ptmotorsport/PT-IMU2CAN/hardware/Altimeter.kicad_sch

## KiCad design hardware/Altimeter.kicad_sch (2026-09-11, an earlier design)

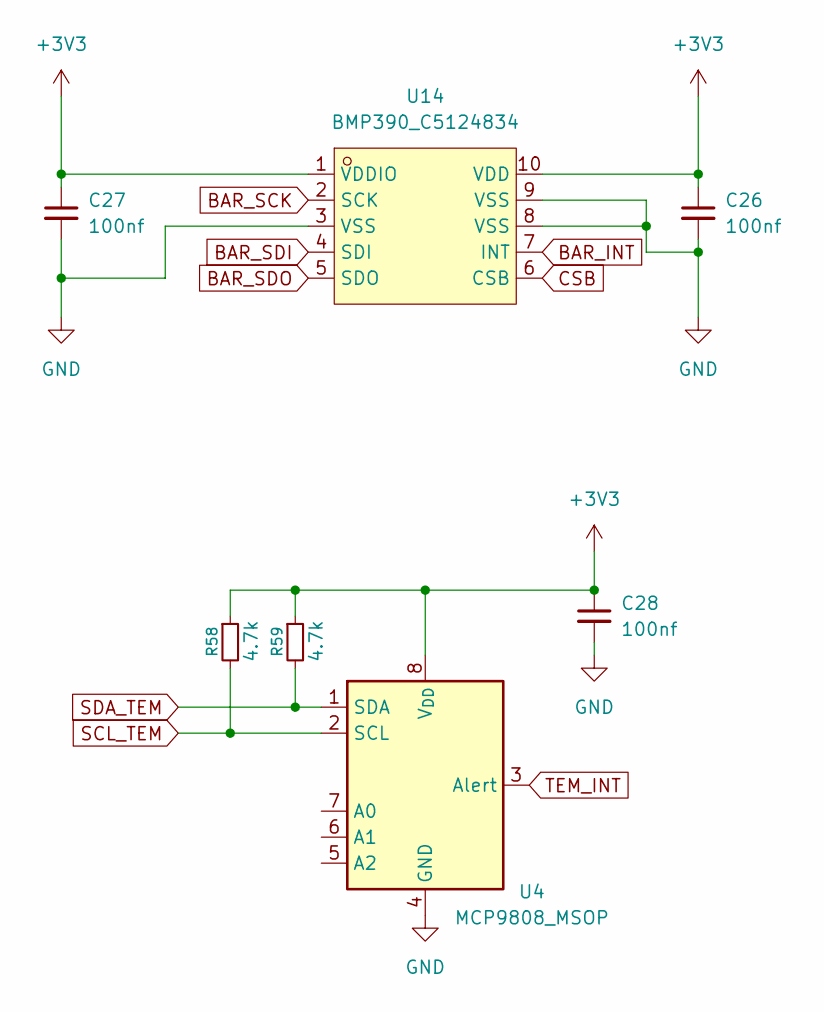
[picture p1: schematic Altimeter.kicad_sch]

Parts:
C26, C27, C28: 100nf
R58, R59: 4.7k
U4: MCP9808_MSOP; MSOP-8_3x3mm_P0.65mm
U14: BMP390_C5124834; LGA-10_L2.0-W2.0-P0.50-BL; MPN BMP390; LCSC Part C5124834

Connections:
+3V3: C26.1, C27.1, C28.1, R58.1, R59.1, U4.8 (V_{DD}), U14.1 (VDDIO), U14.10 (VDD)
BAR_INT: U14.7 (INT)
BAR_SCK: U14.2 (SCK)
BAR_SDI: U14.4 (SDI)
BAR_SDO: U14.5 (SDO)
CSB: U14.6 (CSB)
GND: C26.2, C27.2, C28.2, U4.4 (GND), U14.3 (VSS), U14.8 (VSS), U14.9 (VSS)
SCL_TEM: R58.2, U4.2 (SCL)
SDA_TEM: R59.2, U4.1 (SDA)
TEM_INT: U4.3 (Alert)
