ptmotorsport/PT-IMU2CAN/hardware/CAN.kicad_sch

## KiCad design hardware/CAN.kicad_sch (2026-07-16)

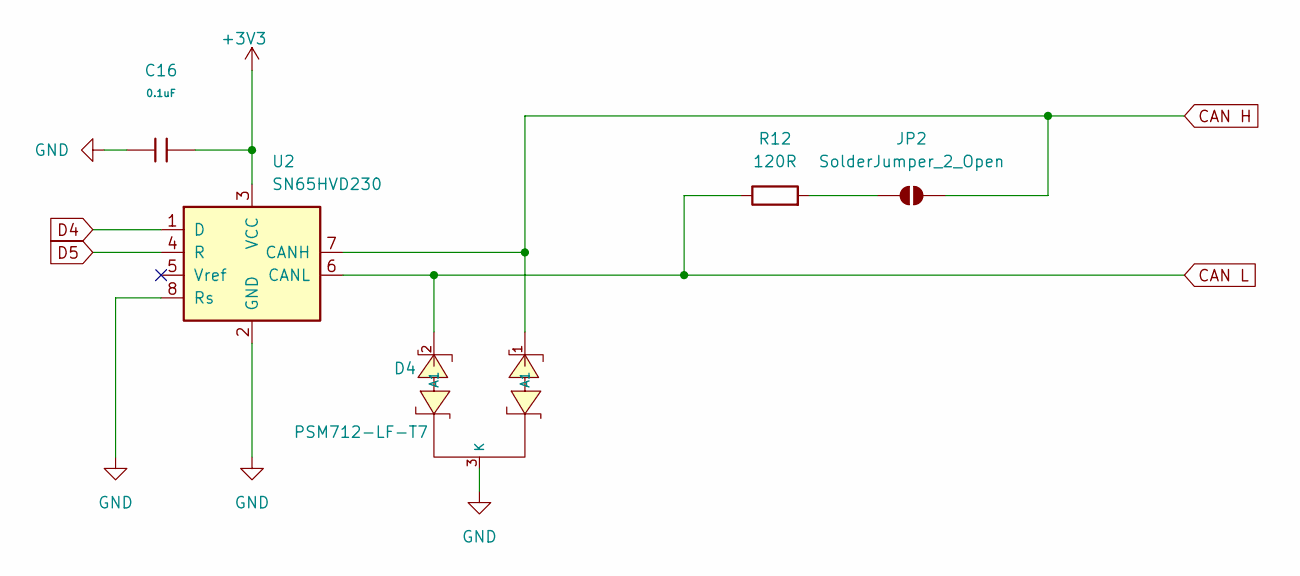
[picture p2: schematic CAN.kicad_sch]

Parts:
C16: 0.1uF; C_0402_1005Metric
D4: PSM712-LF-T7; SOT-23-3; Breakdown Voltage 13.3V; Part PSM712-LF-T7; LCSC C32677
JP2: SolderJumper_2_Open; SolderJumper-2_P1.3mm_Open_RoundedPad1.0x1.5mm
R12: 120R; R_0603_1608Metric
U2: SN65HVD230; SOIC-8_3.9x4.9mm_P1.27mm

Connections:
+3V3: C16.2, U2.3 (VCC)
CAN H: D4.1 (A1), JP2.2 (B), U2.7 (CANH)
CAN L: D4.2 (A1), R12.1, U2.6 (CANL)
D4: U2.1 (D)
D5: U2.4 (R)
GND: C16.1, D4.3 (K), U2.2 (GND), U2.8 (Rs)
unnamed: JP2.1 (A), R12.2
