ptmotorsport/PT-IMU2CAN/hardware/Connectors.kicad_sch

## KiCad design hardware/Connectors.kicad_sch (2026-07-16)

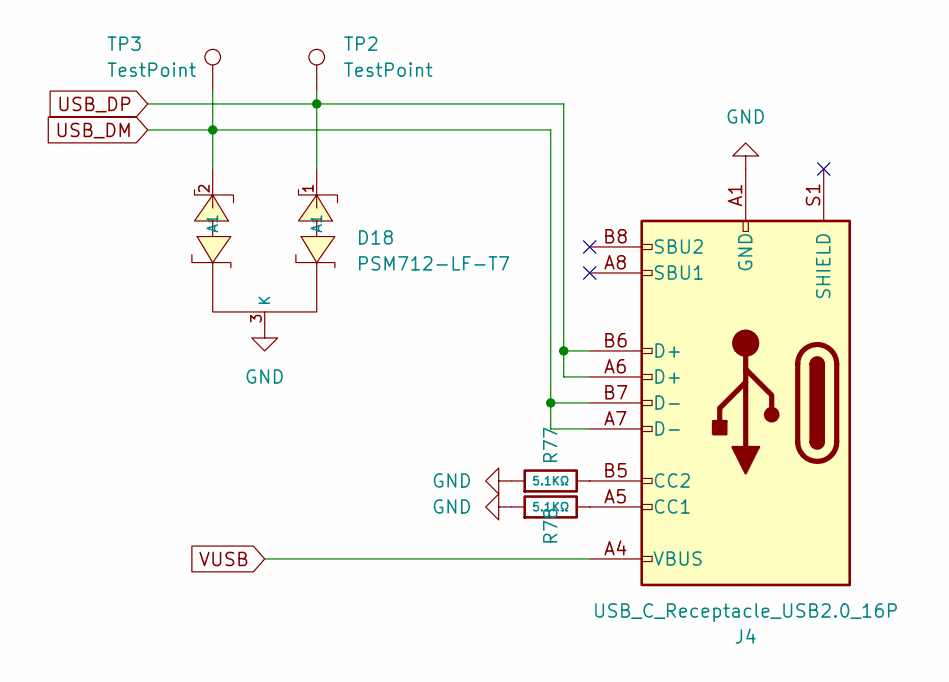
[picture p3: schematic Connectors.kicad_sch]

Parts:
D18: PSM712-LF-T7; SOT-23-3; Breakdown Voltage 13.3V; Part PSM712-LF-T7; LCSC C32677
J4: USB_C_Receptacle_USB2.0_16P; USB_C_Receptacle_GCT_USB4105-xx-A_16P_TopMnt_Horizontal; LCSC C393939
R77, R78: 5.1KΩ; R_0402_1005Metric; Overload Voltage (Max) 50V; Tolerance ±1%; Part 0402WGF1501TCE; LCSC C25867
TP2, TP3: TestPoint; TestPoint_Pad_D1.5mm

Connections:
GND: D18.3 (K), J4.A1 (GND), J4.A12 (GND), J4.B1 (GND), J4.B12 (GND), R77.1, R78.1
unnamed: J4.A5 (CC1), R78.2
unnamed: J4.B5 (CC2), R77.2
USB_DM: D18.2 (A1), J4.A7 (D-), J4.B7 (D-), TP3.1
USB_DP: D18.1 (A1), J4.A6 (D+), J4.B6 (D+), TP2.1
VUSB: J4.A4 (VBUS), J4.A9 (VBUS), J4.B4 (VBUS), J4.B9 (VBUS)
