ptmotorsport/PT-IMU2CAN/hardware/GPS.kicad_sch

## KiCad design hardware/GPS.kicad_sch (2026-09-11, an earlier design)

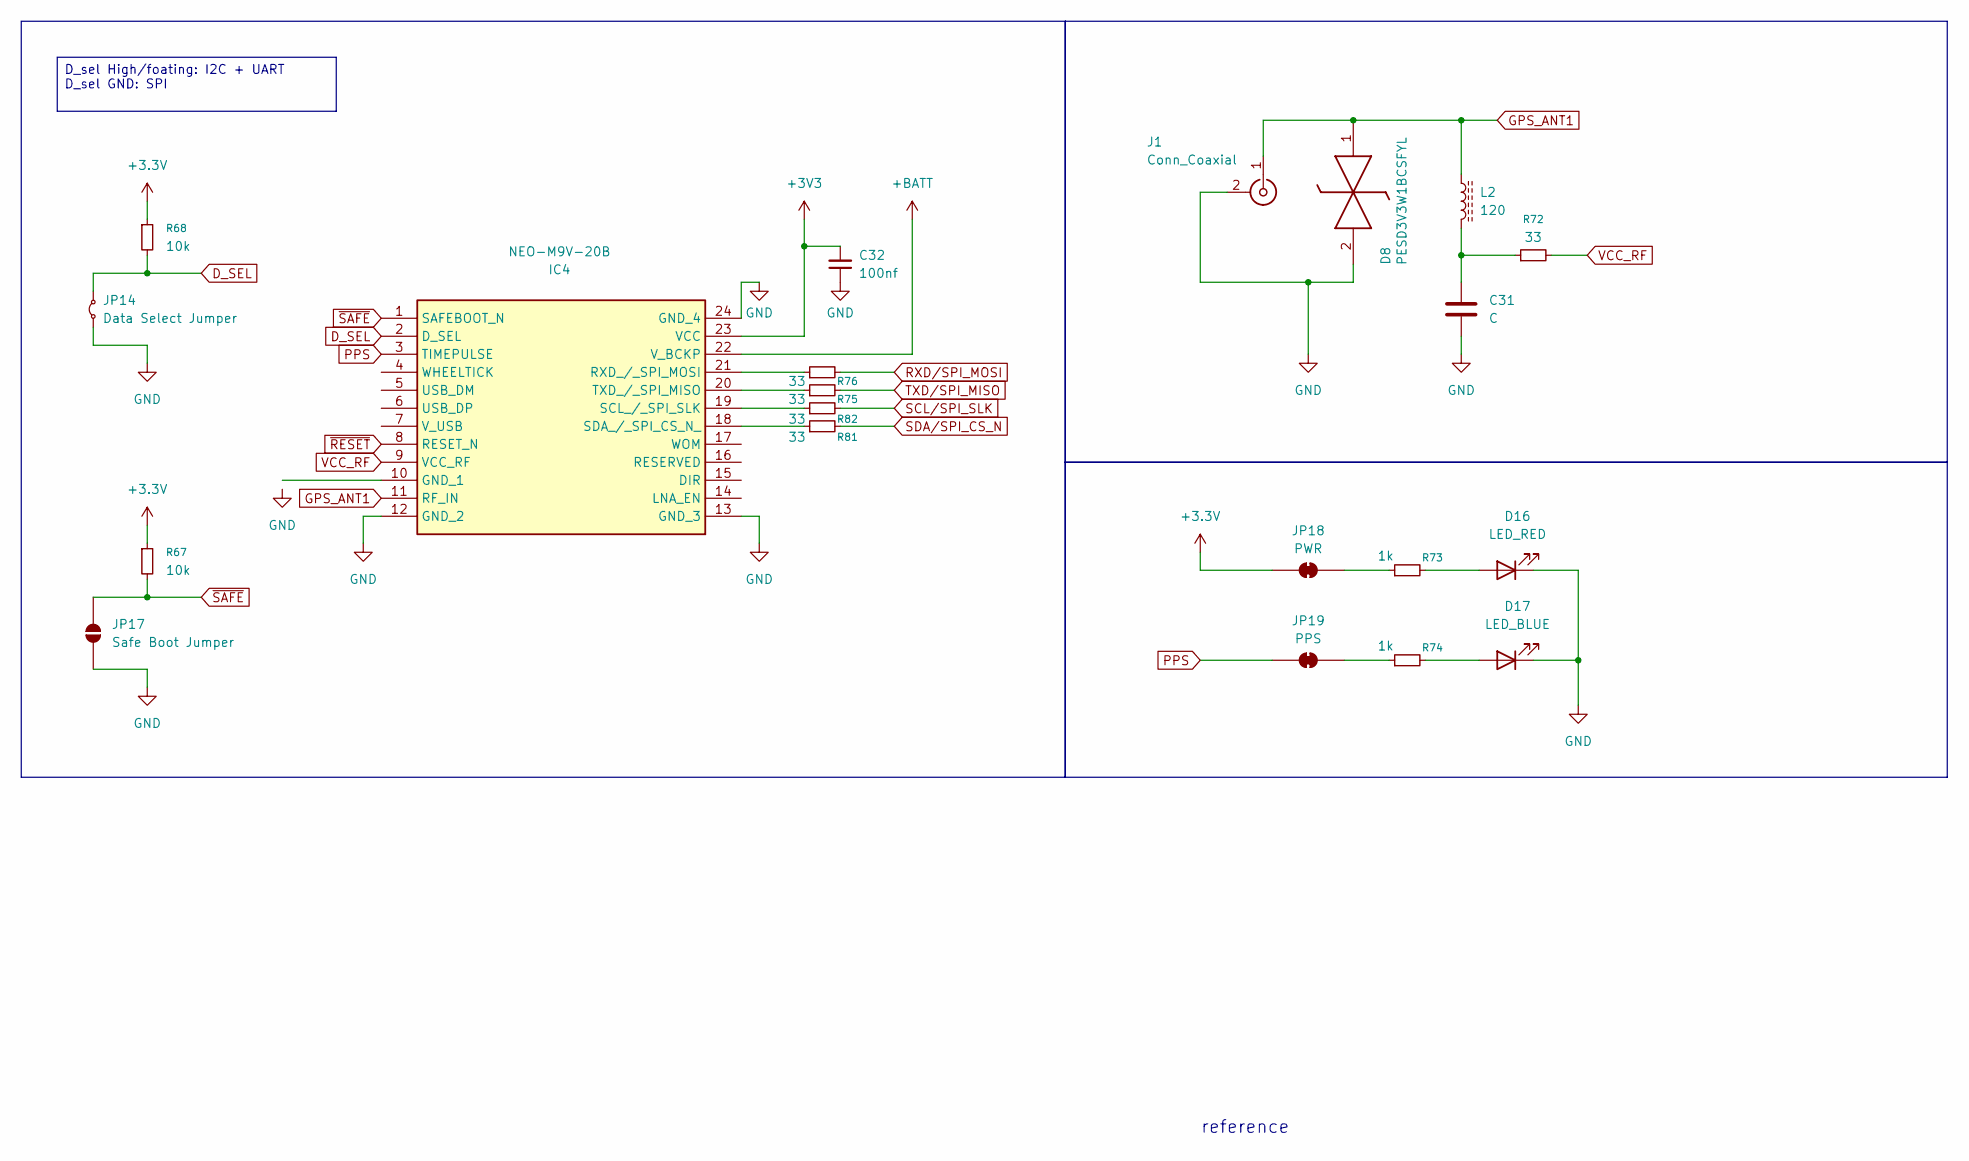
[picture p4: schematic GPS.kicad_sch]

Parts:
C31: C
C32: 100nf
D8: PESD3V3W1BCSFYL; PMEG3005AESFYL; Mouser Part Number 771-PESD3V3W1BCSFYL
D16: LED_RED
D17: LED_BLUE
IC4: NEO-M9V-20B; NEOM9V20B; Mouser Part Number 377-NEO-M9V-20B
J1: Conn_Coaxial
JP14: Data Select Jumper
JP17: Safe Boot Jumper
JP18: PWR
JP19: PPS
L2: 120
R67, R68: 10k
R72, R75, R76, R81, R82: 33
R73, R74: 1k

Connections:
+3.3V: JP18.1 (A), R67.1, R68.1
+3V3: C32.2, IC4.23 (VCC)
+BATT: IC4.22 (V_BCKP)
D_SEL: IC4.2 (D_SEL), JP14.2 (B), R68.2
GND: C31.2, C32.1, D8.2 (K2), D16.1 (K), D17.1 (K), IC4.12 (GND_2), IC4.13 (GND_3), IC4.24 (GND_4), J1.2 (Ext), JP14.1 (A), JP17.1 (A)
GPS_ANT1: D8.1 (K1), IC4.11 (RF_IN), J1.1 (In), L2.1
unnamed: C31.1, L2.2, R72.1
unnamed: D16.2 (A), R73.2
unnamed: D17.2 (A), R74.2
unnamed: IC4.18 (SDA_/_SPI_CS_N_), R81.1
unnamed: IC4.19 (SCL_/_SPI_SLK), R82.1
unnamed: IC4.20 (TXD_/_SPI_MISO), R75.1
unnamed: IC4.21 (RXD_/_SPI_MOSI), R76.1
unnamed: JP18.2 (B), R73.1
unnamed: JP19.2 (B), R74.1
PPS: IC4.3 (TIMEPULSE), JP19.1 (A)
RXD/SPI_MOSI: R76.2
SCL/SPI_SLK: R82.2
SDA/SPI_CS_N: R81.2
TXD/SPI_MISO: R75.2
VCC_RF: IC4.9 (VCC_RF), R72.2
~RESET: IC4.8 (RESET_N)
~SAFE: IC4.1 (SAFEBOOT_N), JP17.2 (B), R67.2

Notes on the sheet:
reference
D_sel High/foating: I2C + UART D_sel GND: SPI
