ptmotorsport/PT-IMU2CAN/hardware/IMU.kicad_sch

## KiCad design hardware/IMU.kicad_sch (2026-09-11, an earlier design)

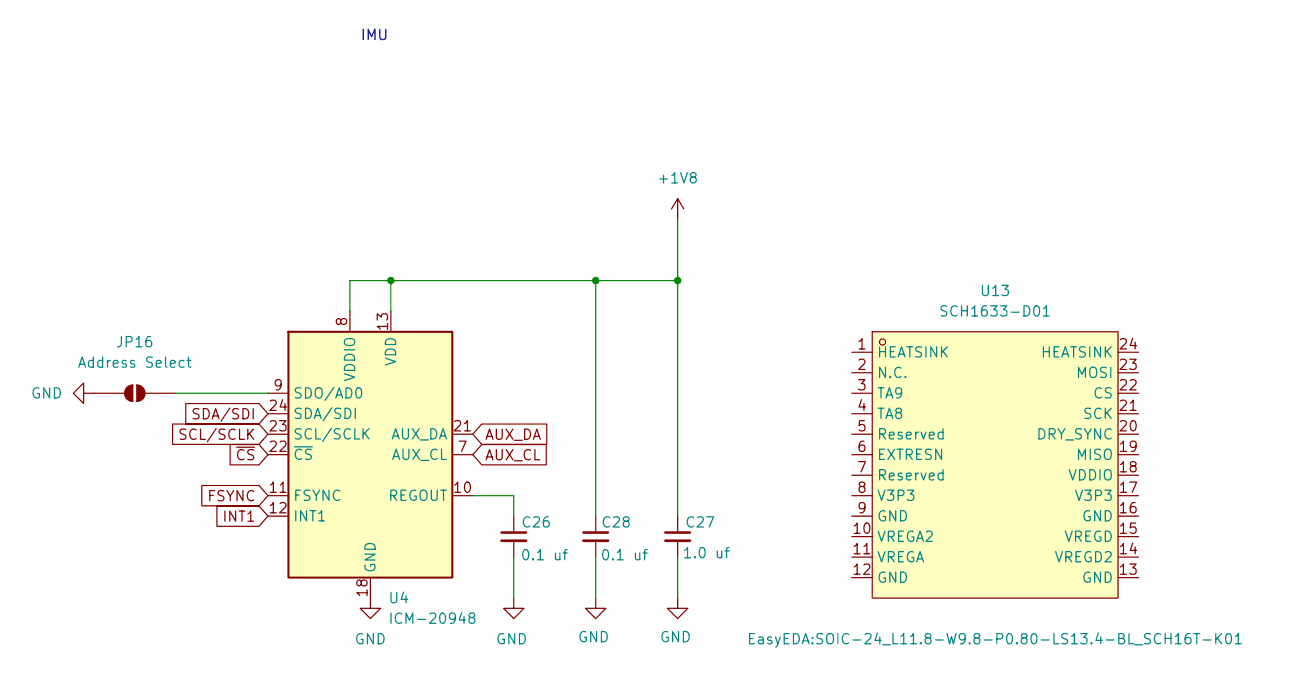
[picture p5: schematic IMU.kicad_sch]

Parts:
C26, C28: 0.1 uf
C27: 1.0 uf
JP16: Address Select
U4: ICM-20948; InvenSense_QFN-24_3x3mm_P0.4mm
U13: SCH1633-D01; SOIC-24_L11.8-W9.8-P0.80-LS13.4-BL_SCH16T-K01; MPN SCH1633-D01; LCSC Part C52174918

Connections:
+1V8: C27.1, C28.1, U4.8 (VDDIO), U4.13 (VDD)
AUX_CL: U4.7 (AUX_CL)
AUX_DA: U4.21 (AUX_DA)
FSYNC: U4.11 (FSYNC)
GND: C26.2, C27.2, C28.2, JP16.1 (A), U4.18 (GND), U4.20 (GND)
INT1: U4.12 (INT1)
unnamed: C26.1, U4.10 (REGOUT)
unnamed: JP16.2 (B), U4.9 (SDO/AD0)
SCL/SCLK: U4.23 (SCL/SCLK)
SDA/SDI: U4.24 (SDA/SDI)
~CS: U4.22 (~CS)

Notes on the sheet:
IMU
