ptmotorsport/PT-IMU2CAN/hardware/Inputs.kicad_sch

## KiCad design hardware/Inputs.kicad_sch (2026-07-16)

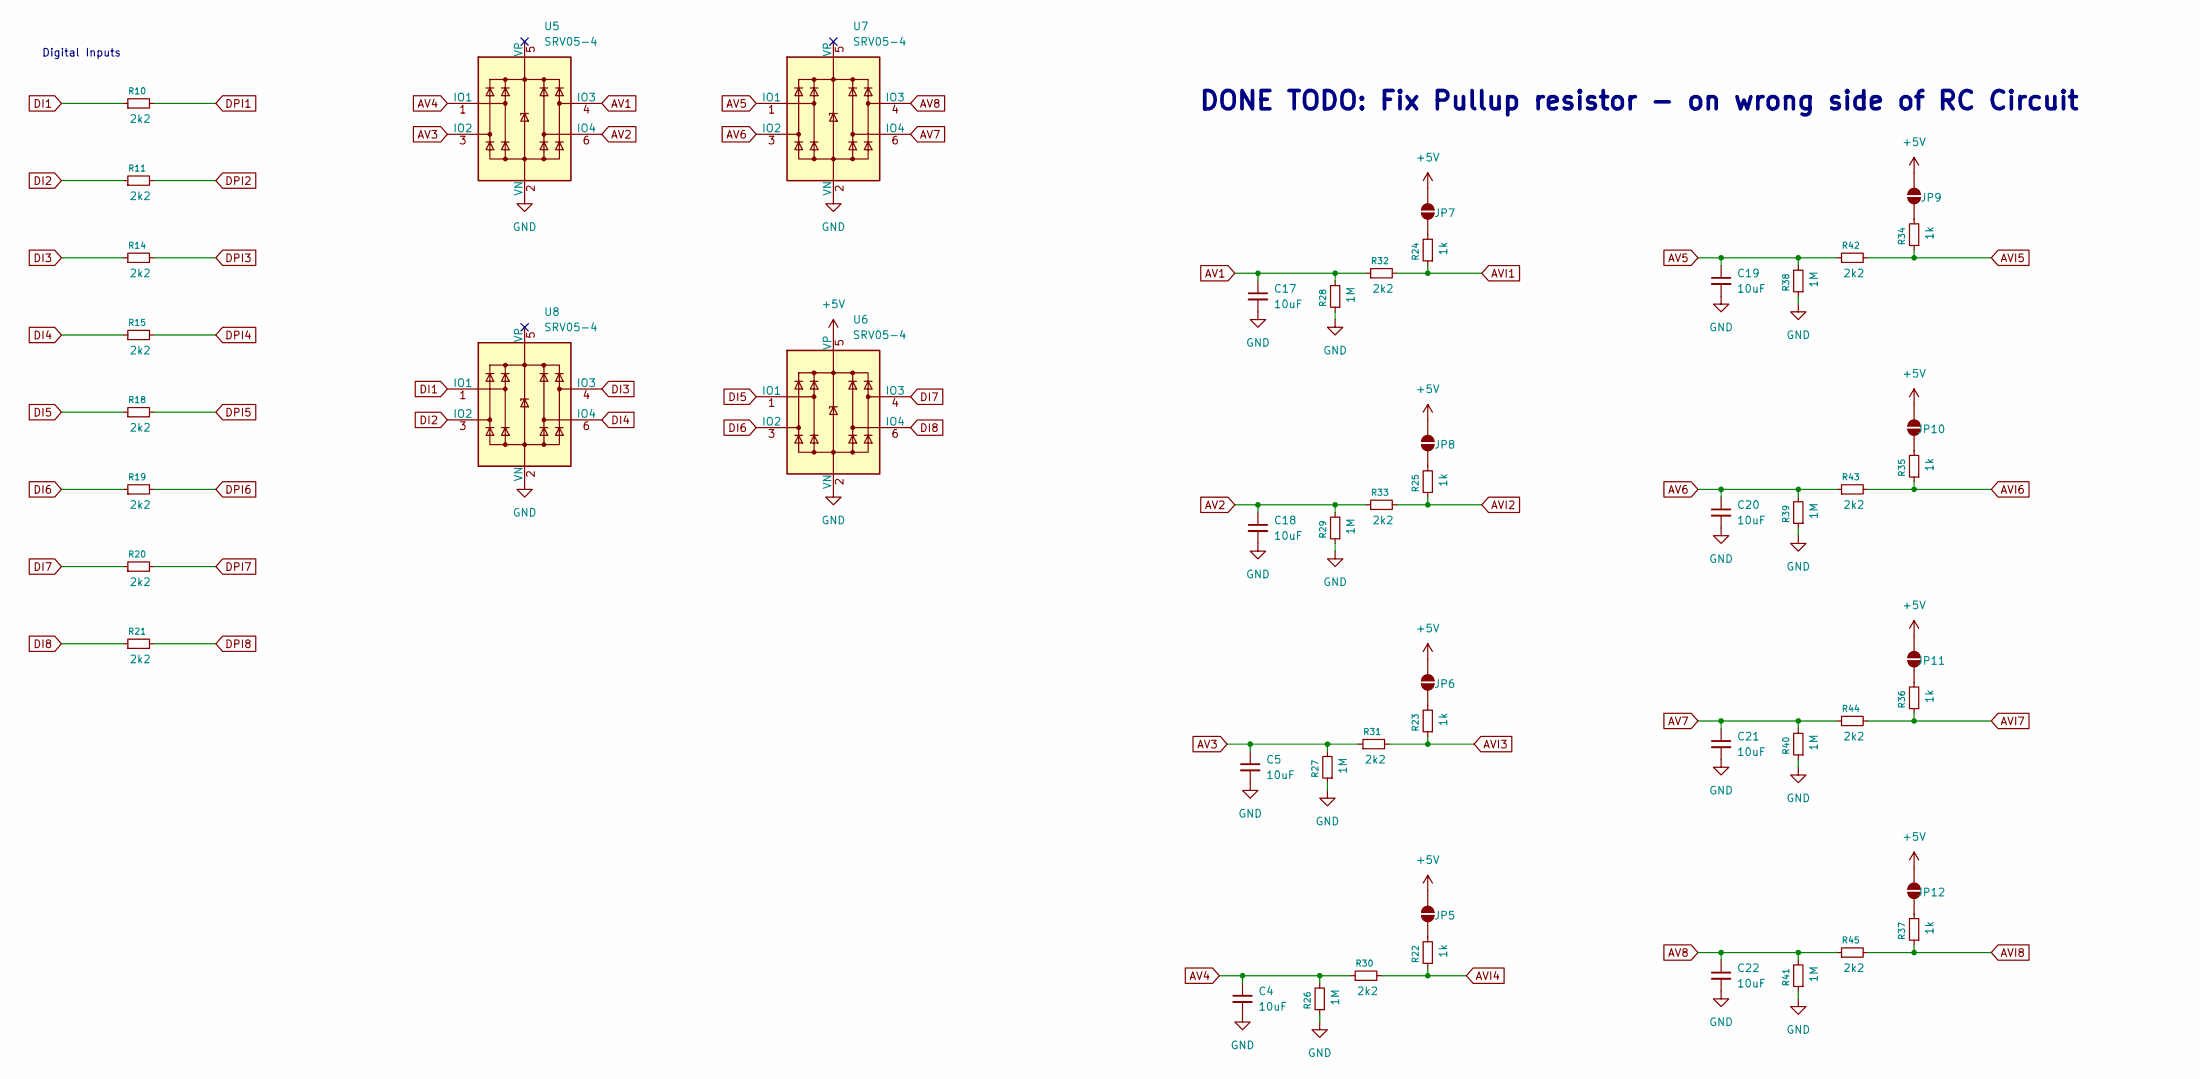
[picture p6: schematic Inputs.kicad_sch]

Parts:
C4, C5, C17, C18, C19, C20, C21, C22: 10uF; C_0402_1005Metric
JP5, JP6, JP7, JP8, JP9, JP10, JP11, JP12: SolderJumper_2_Open; SolderJumper-2_P1.3mm_Open_RoundedPad1.0x1.5mm
R10, R11, R14, R15, R18, R19, R20, R21, R30, R31, R32, R33, R42, R43, R44, R45: 2k2; R_0402_1005Metric
R22, R23, R24, R25, R34, R35, R36, R37: 1k; R_0402_1005Metric
R26, R27, R28, R29, R38, R39, R40, R41: 1M; R_0402_1005Metric
U5, U6, U7, U8: SRV05-4; SOT-23-6

Connections:
+5V: JP5.2 (B), JP6.2 (B), JP7.2 (B), JP8.2 (B), JP9.2 (B), JP10.2 (B), JP11.2 (B), JP12.2 (B), U6.5 (VP)
AV1: C17.1, R28.2, R32.1, U5.4 (IO3)
AV2: C18.1, R29.2, R33.1, U5.6 (IO4)
AV3: C5.1, R27.2, R31.1, U5.3 (IO2)
AV4: C4.1, R26.2, R30.1, U5.1 (IO1)
AV5: C19.1, R38.2, R42.1, U7.1 (IO1)
AV6: C20.1, R39.2, R43.1, U7.3 (IO2)
AV7: C21.1, R40.2, R44.1, U7.6 (IO4)
AV8: C22.1, R41.2, R45.1, U7.4 (IO3)
AVI1: R24.1, R32.2
AVI2: R25.1, R33.2
AVI3: R23.1, R31.2
AVI4: R22.1, R30.2
AVI5: R34.1, R42.2
AVI6: R35.1, R43.2
AVI7: R36.1, R44.2
AVI8: R37.1, R45.2
DI1: R10.1, U8.1 (IO1)
DI2: R11.1, U8.3 (IO2)
DI3: R14.1, U8.4 (IO3)
DI4: R15.1, U8.6 (IO4)
DI5: R18.1, U6.1 (IO1)
DI6: R19.1, U6.3 (IO2)
DI7: R20.1, U6.4 (IO3)
DI8: R21.1, U6.6 (IO4)
DPI1: R10.2
DPI2: R11.2
DPI3: R14.2
DPI4: R15.2
DPI5: R18.2
DPI6: R19.2
DPI7: R20.2
DPI8: R21.2
GND: C4.2, C5.2, C17.2, C18.2, C19.2, C20.2, C21.2, C22.2, R26.1, R27.1, R28.1, R29.1, R38.1, R39.1, R40.1, R41.1, U5.2 (VN), U6.2 (VN), U7.2 (VN), U8.2 (VN)
unnamed: JP5.1 (A), R22.2
unnamed: JP6.1 (A), R23.2
unnamed: JP7.1 (A), R24.2
unnamed: JP8.1 (A), R25.2
unnamed: JP9.1 (A), R34.2
unnamed: JP10.1 (A), R35.2
unnamed: JP11.1 (A), R36.2
unnamed: JP12.1 (A), R37.2

Notes on the sheet:
DONE TODO: Fix Pullup resistor - on wrong side of RC Circuit
Digital Inputs
