ptmotorsport/PT-IMU2CAN/hardware/LEDs.kicad_sch

## KiCad design hardware/LEDs.kicad_sch (2026-07-16)

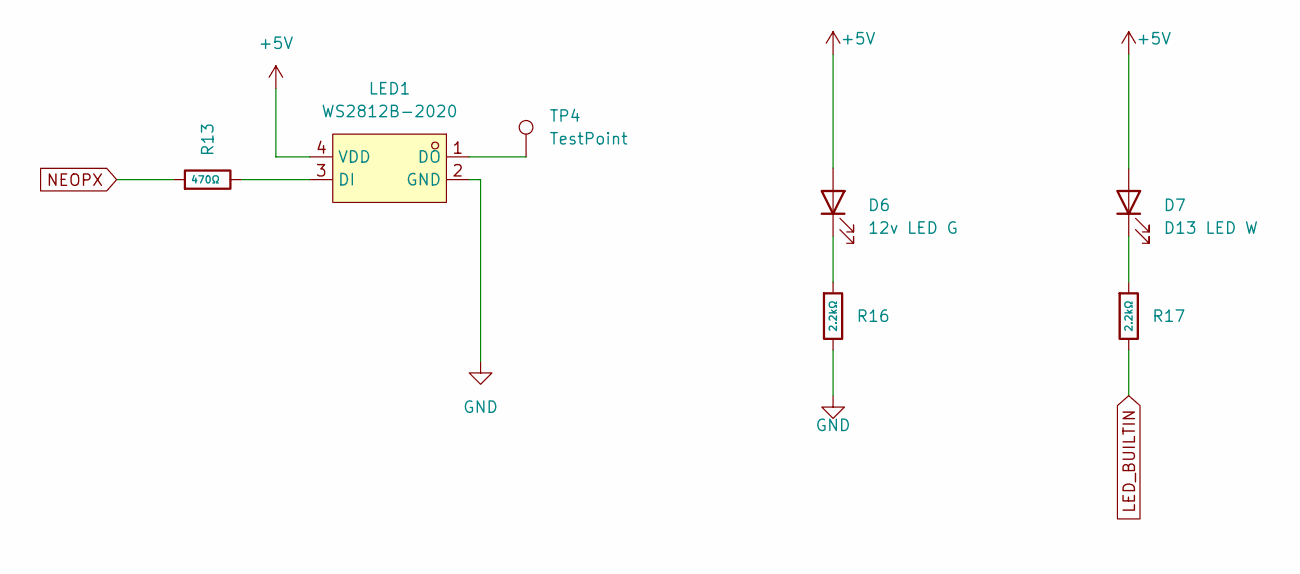
[picture p7: schematic LEDs.kicad_sch]

Parts:
D6: 12v LED G; LED_0402_1005Metric
D7: D13 LED W; LED_0402_1005Metric
LED1: WS2812B-2020; LED-SMD_4P-L2.0-W2.0-TL_WS2812B-2020; LCSC Part C965555
R13: 470Ω; R_0402_1005Metric; Overload Voltage (Max) 50V; Tolerance ±1%; Part 0402WGF1501TCE; LCSC C25867
R16, R17: 2.2kΩ; R_0402_1005Metric
TP4: TestPoint; TestPoint_Pad_D1.5mm

Connections:
+5V: D6.2 (A), D7.2 (A), LED1.4 (VDD)
GND: LED1.2 (GND), R16.2
LED_BUILTIN: R17.2
NEOPX: R13.1
unnamed: D6.1 (K), R16.1
unnamed: D7.1 (K), R17.1
unnamed: LED1.1 (DO), TP4.1
unnamed: LED1.3 (DI), R13.2
