ptmotorsport/PT-IMU2CAN/hardware/MCU_Power.kicad_sch

## KiCad design hardware/MCU_Power.kicad_sch (2026-09-11, an earlier design)

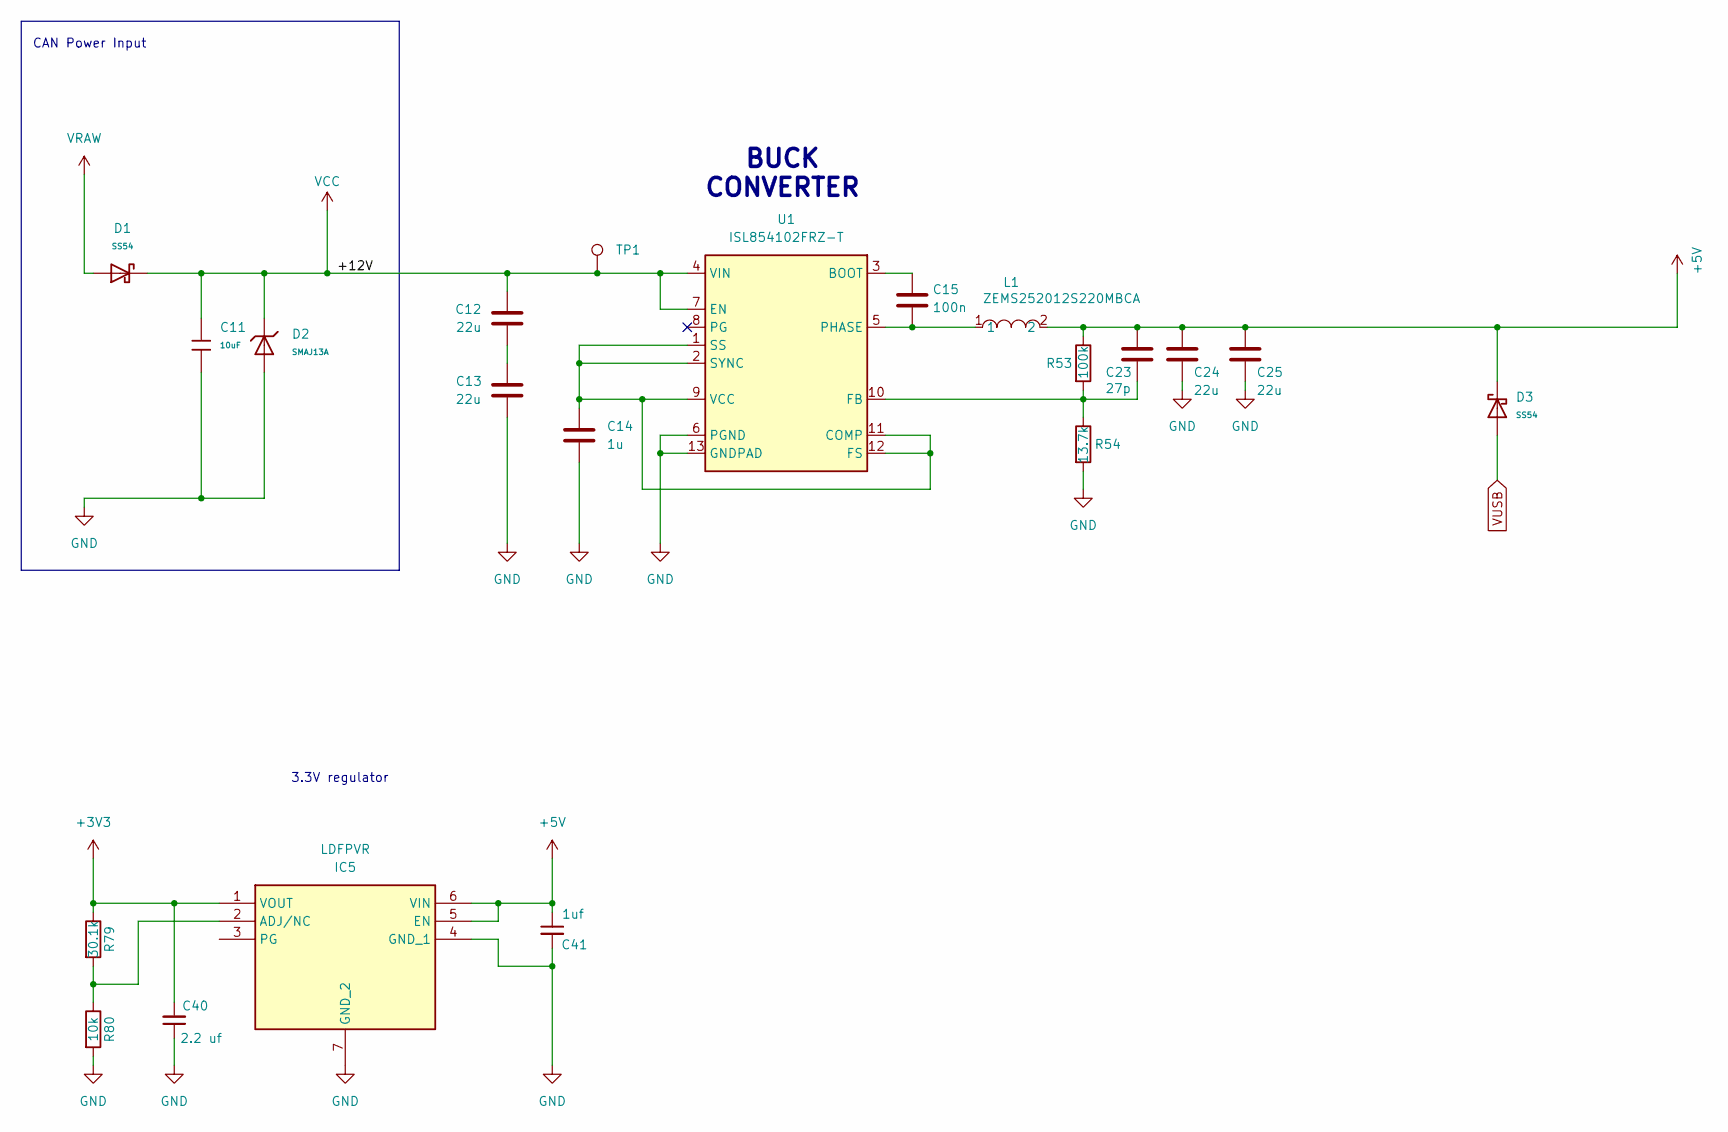
[picture p8: schematic MCU_Power.kicad_sch]

Parts:
C11: 10uF; C_1206_3216Metric
C12, C13, C24, C25: 22u; C_0805_2012Metric
C14: 1u; C_0402_1005Metric
C15: 100n; C_0402_1005Metric
C23: 27p; C_0402_1005Metric
C40: 2.2 uf
C41: 1uf
D1, D3: SS54; D_SMA; Forward Voltage (Vf@If) 550mV@5A; Reverse Voltage (Vr) 40V; Part SS54; LCSC C22452
D2: SMAJ13A; D_SMA; Part SMAJ13A; LCSC C19077533
IC5: LDFPVR; SON65P200X200X100-7N-D; Mouser Part Number 511-LDFPVR
L1: ZEMS252012S220MBCA; IND-SMD_L2.5-W2.0_ZEMS252012S; LCSC Part C48945696
R53: 100k; R_0402_1005Metric
R54: 13.7k; R_0402_1005Metric
R79: 30.1k
R80: 10k
TP1: TestPoint; TestPoint_Pad_D3.0mm
U1: ISL854102FRZ-T; DFN-12-1EP_3x4mm_P0.5mm_EP1.7x3.3mm

Connections:
+3V3: C40.2, IC5.1 (VOUT), R79.1
+5V: C23.1, C24.1, C25.1, C41.1, D3.1, IC5.5 (EN), IC5.6 (VIN), L1.2, R53.1
GND: C11.2, C13.2, C14.2, C24.2, C25.2, C40.1, C41.2, D2.2, IC5.4 (GND_1), IC5.7 (GND_2), R54.2, R80.2, U1.6 (PGND), U1.13 (GNDPAD)
unnamed: C12.1, C13.1
unnamed: C14.1, U1.1 (SS), U1.2 (SYNC), U1.9 (VCC), U1.11 (COMP), U1.12 (FS)
unnamed: C15.1, U1.3 (BOOT)
unnamed: C15.2, L1.1, U1.5 (PHASE)
unnamed: C23.2, R53.2, R54.1, U1.10 (FB)
unnamed: IC5.2 (ADJ/NC), R79.2, R80.1
VCC: C11.1, C12.2, D1.1, D2.1, TP1.1, U1.4 (VIN), U1.7 (EN)
VRAW: D1.2
VUSB: D3.2

Notes on the sheet:
BUCK CONVERTER
CAN Power Input
3.3V regulator
