ptmotorsport/PT-IMU2CAN/hardware/Magnetometer.kicad_sch

## KiCad design hardware/Magnetometer.kicad_sch (2026-09-11, an earlier design)

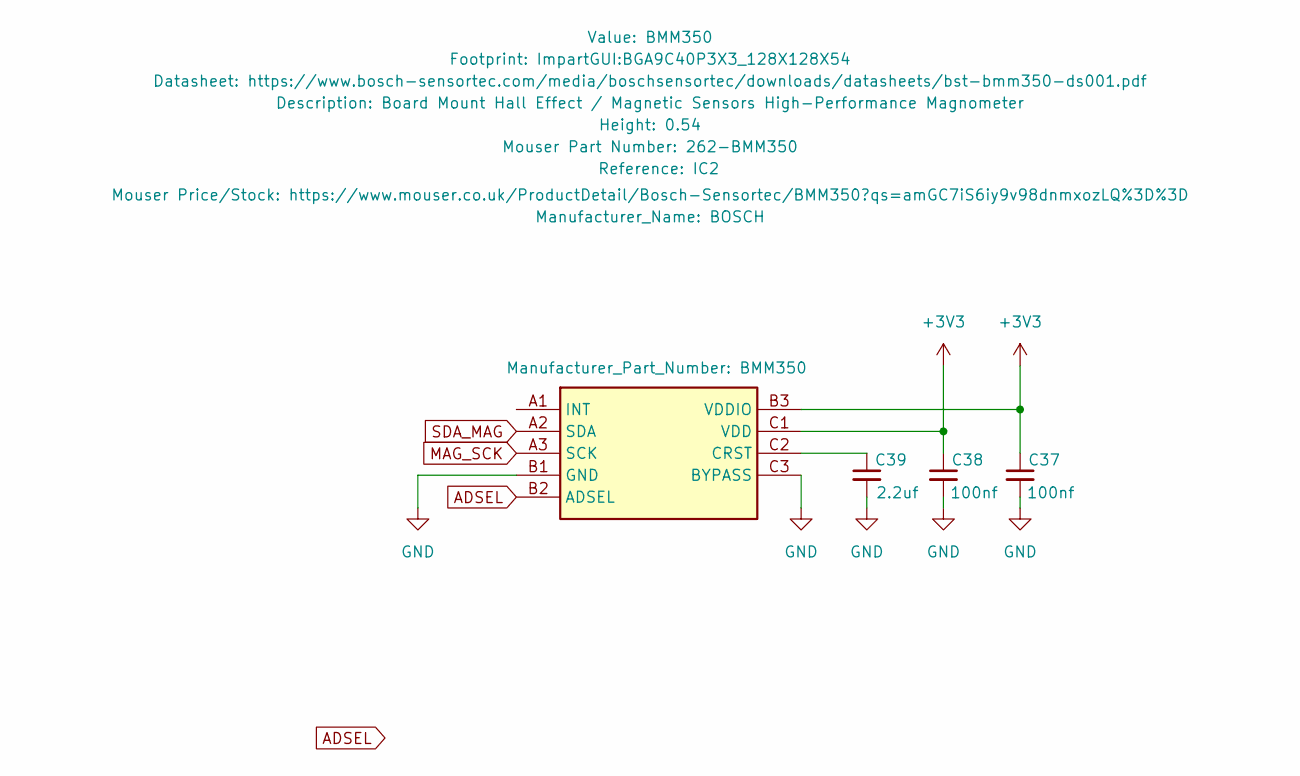
[picture p9: schematic Magnetometer.kicad_sch]

Parts:
C37, C38: 100nf
C39: 2.2uf
IC2: BMM350; BGA9C40P3X3_128X128X54; Mouser Part Number 262-BMM350

Connections:
+3V3: C37.1, C38.1, IC2.B3 (VDDIO), IC2.C1 (VDD)
ADSEL: IC2.B2 (ADSEL)
GND: C37.2, C38.2, C39.2, IC2.B1 (GND), IC2.C3 (BYPASS)
MAG_SCK: IC2.A3 (SCK)
unnamed: C39.1, IC2.C2 (CRST)
SDA_MAG: IC2.A2 (SDA)
