ptmotorsport/PT-IMU2CAN/hardware/Outputs.kicad_sch

## KiCad design hardware/Outputs.kicad_sch (2026-07-16)

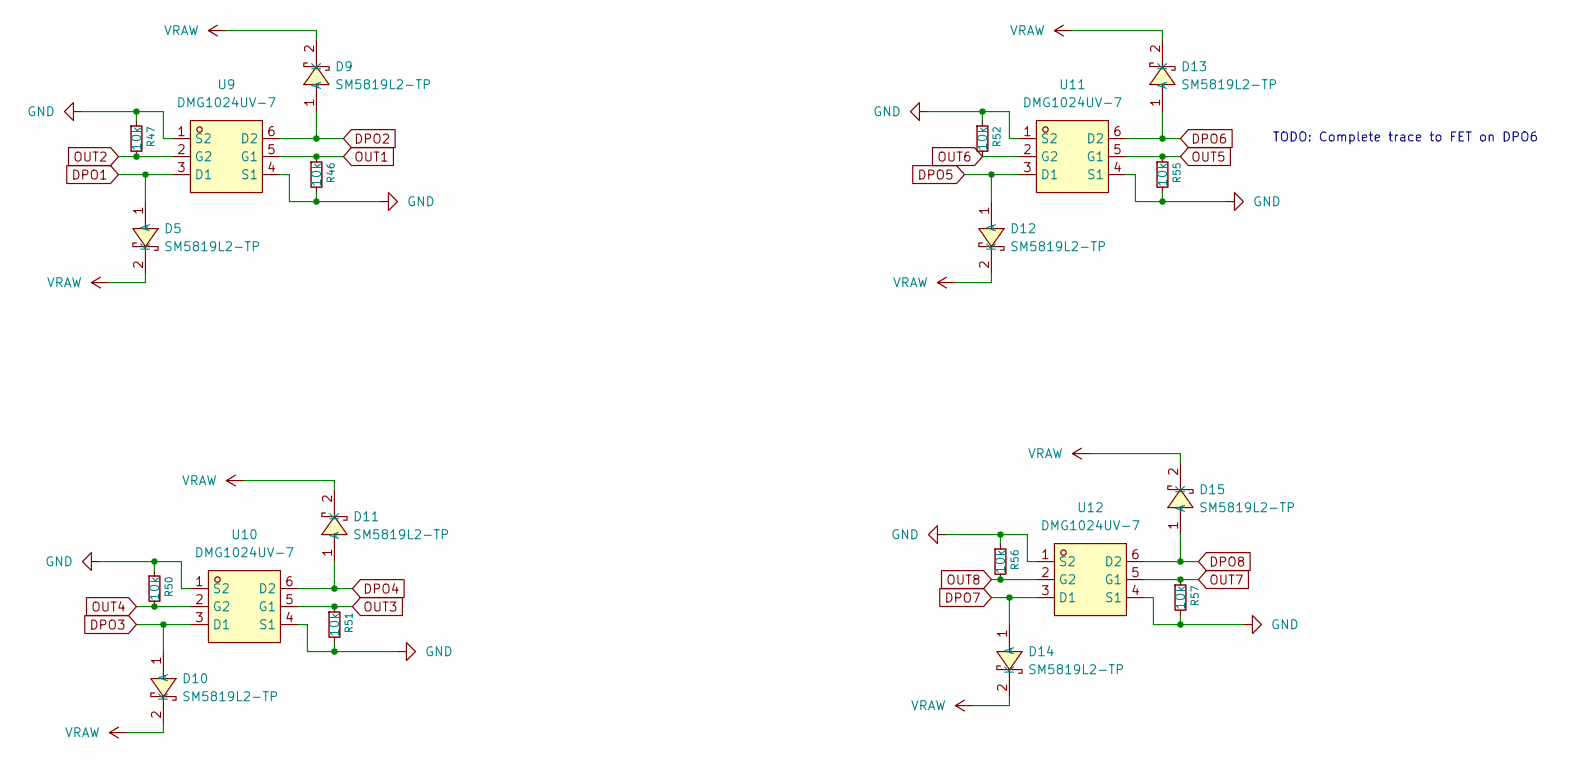
[picture p10: schematic Outputs.kicad_sch]

Parts:
D5, D9, D10, D11, D12, D13, D14, D15: SM5819L2-TP; SLP1006P2T_L1.0-W0.6-P0.65-FD; LCSC Part C6297199
R46, R47, R50, R51, R52, R55, R56, R57: 10k; R_0402_1005Metric
U9, U10, U11, U12: DMG1024UV-7; SOT-563-6_L1.6-W1.2-P0.5-LS1.6-BL; LCSC Part C2759893

Connections:
DPO1: D5.1 (A), U9.3 (D1)
DPO2: D9.1 (A), U9.6 (D2)
DPO3: D10.1 (A), U10.3 (D1)
DPO4: D11.1 (A), U10.6 (D2)
DPO5: D12.1 (A), U11.3 (D1)
DPO6: D13.1 (A), U11.6 (D2)
DPO7: D14.1 (A), U12.3 (D1)
DPO8: D15.1 (A), U12.6 (D2)
GND: R46.2, R47.1, R50.1, R51.2, R52.1, R55.2, R56.1, R57.2, U9.1 (S2), U9.4 (S1), U10.1 (S2), U10.4 (S1), U11.1 (S2), U11.4 (S1), U12.1 (S2), U12.4 (S1)
OUT1: R46.1, U9.5 (G1)
OUT2: R47.2, U9.2 (G2)
OUT3: R51.1, U10.5 (G1)
OUT4: R50.2, U10.2 (G2)
OUT5: R55.1, U11.5 (G1)
OUT6: R52.2, U11.2 (G2)
OUT7: R57.1, U12.5 (G1)
OUT8: R56.2, U12.2 (G2)
VRAW: D5.2 (K), D9.2 (K), D10.2 (K), D11.2 (K), D12.2 (K), D13.2 (K), D14.2 (K), D15.2 (K)

Notes on the sheet:
TODO: Complete trace to FET on DPO6
