ptmotorsport/PT-IMU2CAN/hardware/mcu.kicad_sch

## KiCad design hardware/mcu.kicad_sch (2026-09-11, an earlier design)

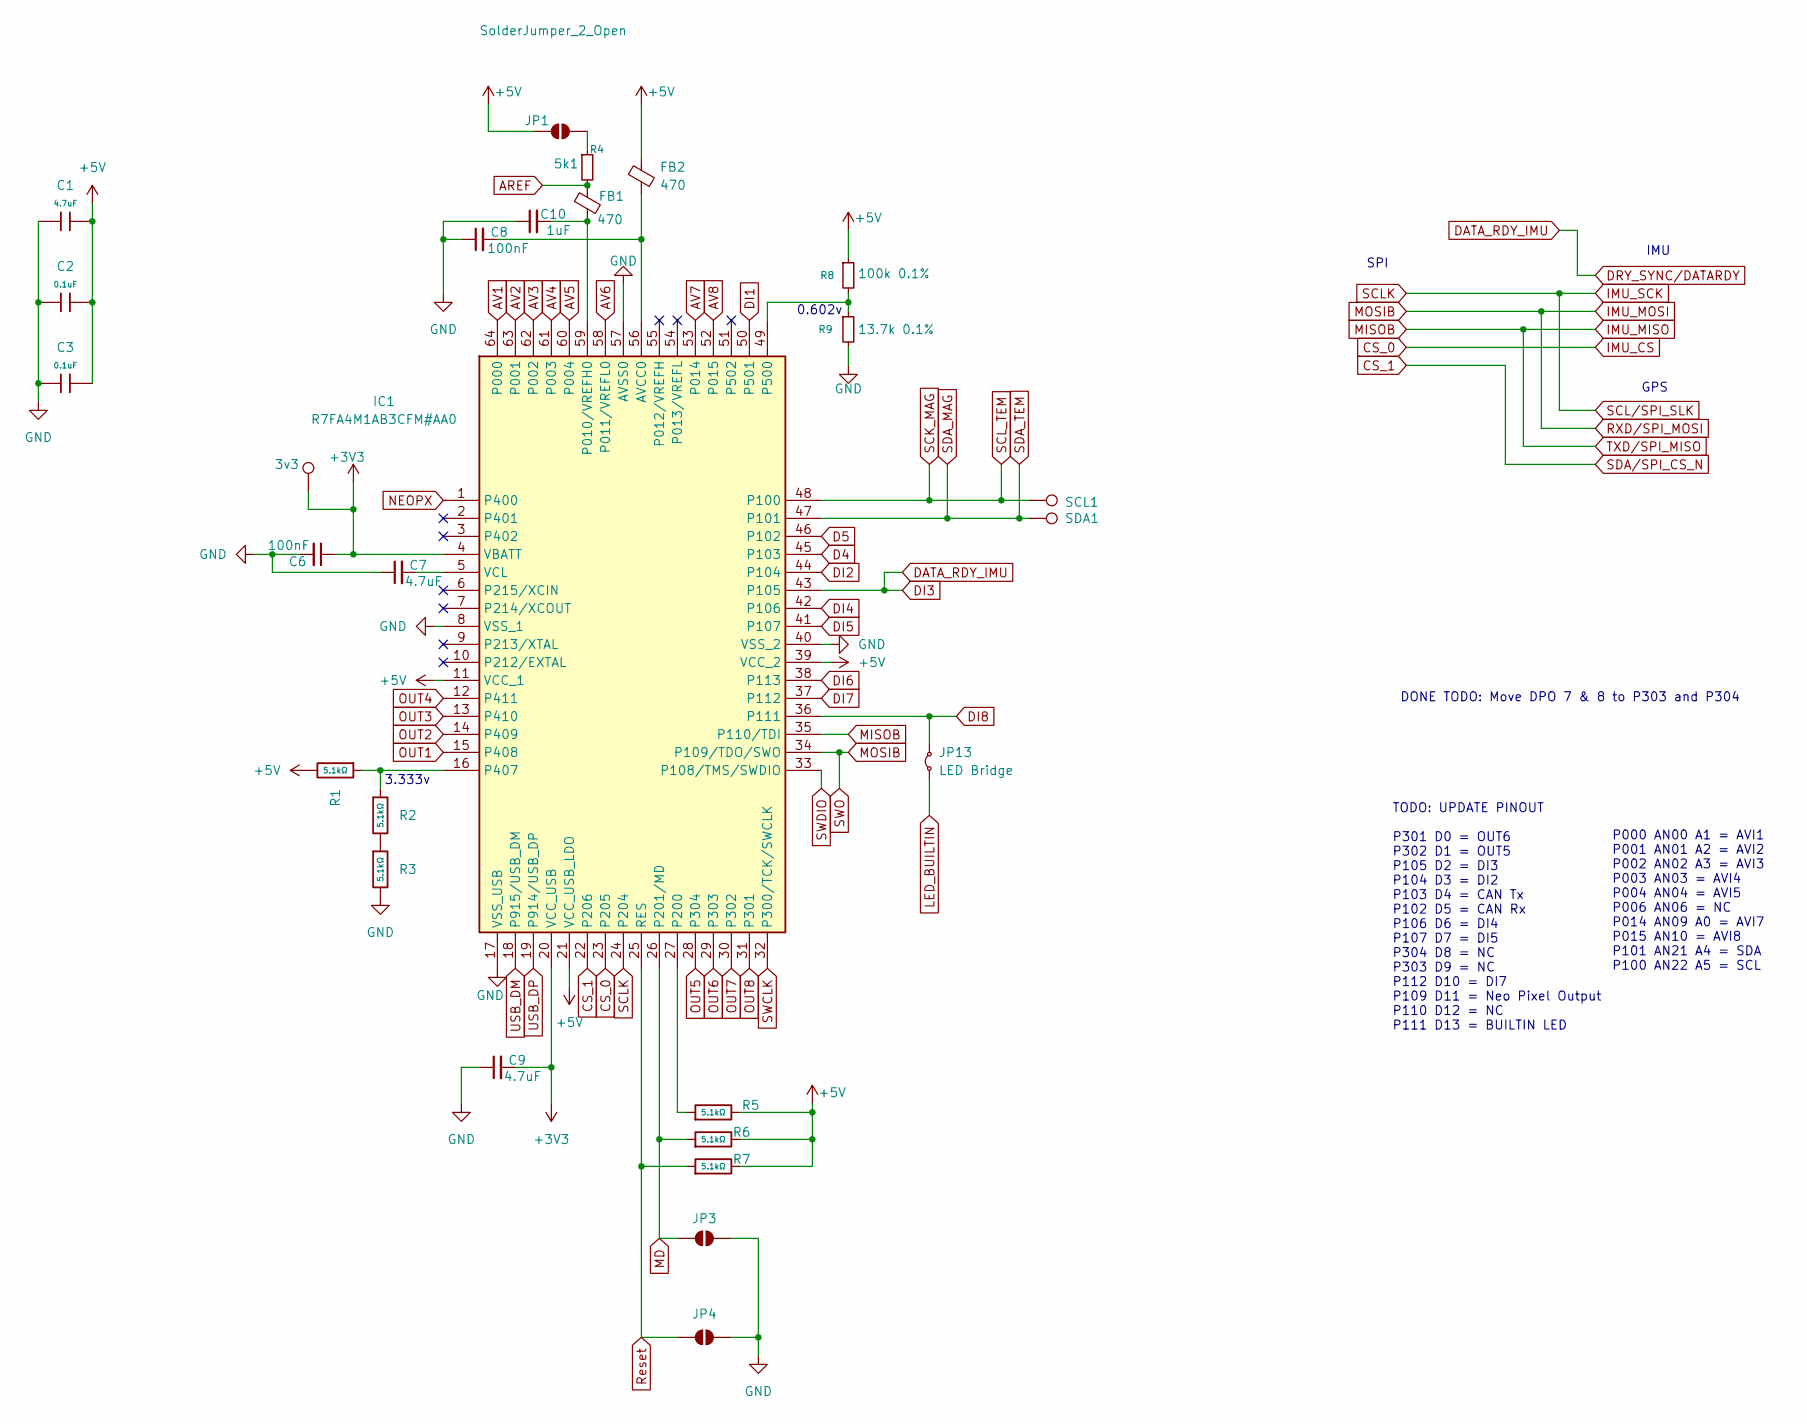
[picture p11: schematic mcu.kicad_sch]

Parts:
3v3: TestPoint; TestPoint_Pad_D1.5mm
C1, C7, C9: 4.7uF; C_0402_1005Metric
C2, C3: 0.1uF; C_0402_1005Metric
C6, C8: 100nF; C_0402_1005Metric
C10: 1uF; C_0402_1005Metric
FB1, FB2: 470; L_0603_1608Metric
IC1: R7FA4M1AB3CFM#AA0; LQFP-64_10x10mm_P0.5mm; Mouser Part Number 968-7FA4M1AB3CFM#AA0
JP1, JP3, JP4: SolderJumper_2_Open; SolderJumper-2_P1.3mm_Open_RoundedPad1.0x1.5mm
JP13: LED Bridge; SolderJumper-2_P1.3mm_Bridged_RoundedPad1.0x1.5mm
R1, R2, R3, R5, R6, R7: 5.1kΩ; R_0402_1005Metric
R4: 5k1; R_0402_1005Metric
R8: 100k 0.1%; R_0402_1005Metric
R9: 13.7k 0.1%; R_0402_1005Metric
SCL1: TestPoint
SDA1: TestPoint

Connections:
+3V3: 3v3.1, C6.1, C9.2, IC1.4 (VBATT), IC1.20 (VCC_USB)
+5V: C1.2, C2.2, C3.2, FB2.1, IC1.11 (VCC_1), IC1.21 (VCC_USB_LDO), IC1.39 (VCC_2), JP1.2 (B), R1.2, R5.2, R6.2, R7.2, R8.1
AREF: FB1.1, R4.2
AV1: IC1.64 (P000)
AV2: IC1.63 (P001)
AV3: IC1.62 (P002)
AV4: IC1.61 (P003)
AV5: IC1.60 (P004)
AV6: IC1.58 (P011/VREFL0)
AV7: IC1.53 (P014)
AV8: IC1.52 (P015)
CS_0: IC1.23 (P205)
CS_1: IC1.22 (P206)
D4: IC1.45 (P103)
D5: IC1.46 (P102)
DATA_RDY_IMU: IC1.43 (P105)
DI1: IC1.50 (P501)
DI2: IC1.44 (P104)
DI4: IC1.42 (P106)
DI5: IC1.41 (P107)
DI6: IC1.38 (P113)
DI7: IC1.37 (P112)
DI8: IC1.36 (P111), JP13.2 (B)
GND: C1.1, C2.1, C3.1, C6.2, C7.1, C8.1, C9.1, C10.1, IC1.8 (VSS_1), IC1.17 (VSS_USB), IC1.40 (VSS_2), IC1.57 (AVSS0), JP3.2 (B), JP4.2 (B), R3.2, R9.2
IMU_MISO: IC1.35 (P110/TDI)
IMU_MOSI: IC1.34 (P109/TDO/SWO)
IMU_SCK: IC1.24 (P204)
LED_BUILTIN: JP13.1 (A)
MD: IC1.26 (P201/MD), JP3.1 (A), R6.1
NEOPX: IC1.1 (P400)
unnamed: C7.2, IC1.5 (VCL)
unnamed: C8.2, FB2.2, IC1.56 (AVCC0)
unnamed: C10.2, FB1.2, IC1.59 (P010/VREFH0)
unnamed: IC1.16 (P407), R1.1, R2.1
unnamed: IC1.27 (P200), R5.1
unnamed: IC1.49 (P500), R8.2, R9.1
unnamed: JP1.1 (A), R4.1
unnamed: R2.2, R3.1
OUT1: IC1.15 (P408)
OUT2: IC1.14 (P409)
OUT3: IC1.13 (P410)
OUT4: IC1.12 (P411)
OUT5: IC1.28 (P304)
OUT6: IC1.29 (P303)
OUT7: IC1.30 (P302)
OUT8: IC1.31 (P301)
Reset: IC1.25 (RES), JP4.1 (A), R7.1
SCK_MAG: IC1.48 (P100), SCL1.1
SDA_MAG: IC1.47 (P101), SDA1.1
SWCLK: IC1.32 (P300/TCK/SWCLK)
SWDIO: IC1.33 (P108/TMS/SWDIO)
USB_DM: IC1.18 (P915/USB_DM)
USB_DP: IC1.19 (P914/USB_DP)

Notes on the sheet:
IMU
TODO: UPDATE PINOUT P301 D0 = OUT6 P302 D1 = OUT5 P105 D2 = DI3 P104 D3 = DI2 P103 D4 = CAN Tx P102 D5 = CAN Rx P106 D6 = DI4 P107 D7 = DI5 P304 D8 = NC P303 D9 = NC P112 D10 = DI7 P109 D11 = Neo Pixel Output P110 D12 = NC P111 D13 = BUILTIN LED
0.602v
DONE TODO: Move DPO 7 & 8 to P303 and P304
SPI
P000 AN00 A1 = AVI1 P001 AN01 A2 = AVI2 P002 AN02 A3 = AVI3 P003 AN03 = AVI4 P004 AN04 = AVI5 P006 AN06 = NC P014 AN09 A0 = AVI7 P015 AN10 = AVI8 P101 AN21 A4 = SDA P100 AN22 A5 = SCL
GPS
3.333v
