ptmotorsport/PT-IMU2CAN/(commit log)

2025-12-17 Initial Commit - IMUtoCAN
2026-01-13 Wrote a kalman filter (very basic) and generalised imu calls. keeping main as is currently to transfer to can layer(wip). Gps also WIP currently testing 2 different sensors signal.
    feature: Kalman filter setup via BLA library (need to reverify matrix
    computation on paper once testing has begun for tuning) might setup a congif.cpp file for easy changes. No heap setup yet (might need if running async queue
    for canbus data logging). Can setup depending on performance on the ra4m1.
    feature: 2 imus polling is setup to po`ll from 2 addresses on the same i2c bus, address set
    through logical high and gnd pin.
    future implementation:
    - working can transfer layer.
    - imu and kalman functionality via m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
2026-02-04 Main loop logic implemented. TODO: rigid body IMU alignment, serial debug messages, python visualisation.
2026-05-05 Fixed EKF integration, added data logging to main loop, added README EKF terms are now integrated properly. IMUs now use fusion, live filtering. Can messages are now being sent off in main loop. fina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
    at this stage only manual testing has been done: test suite in
    development
    [ekf.cpp, ekf.h, gps.cpp, imu.cpp, imu.h, main.cpp]
2026-07-16 Update .gitignore add kicad temp files
2026-07-16 Added self contained KiCad hardware project files. began work on mcu, gps and IMU
    [CAN.kicad_sch, Connectors.kicad_sch, GPS.kicad_sch, IMU.kicad_sch, Inputs.kicad_sch, LEDs.kicad_sch, MCU_Power.kicad_sch, Outputs.kicad_sch]
2026-07-16 revised GPS chip with new TODO item
    [GPS.kicad_sch]
2026-08-03 migrate to impart gui, begin redo of imu schematic
    add to symbol library: ImpartGUI |
    ${KICAD_3RD_PARTY}/ImpartGUI.kicad_sym | format KiCad. add to footprint
    library: ImpartGUI | ${KICAD_3RD_PARTY}/ImpartGUI.pretty | KiCad
    -This is a choice made to keep project portable at the cost of larger
    repo size.
    [GPS.kicad_sch, IMU.kicad_sch]
2026-09-10 wire up altimeter, temp, barometer, imu, gps to MCU
    [Altimeter.kicad_sch, GPS.kicad_sch, MCU_Power.kicad_sch, Magnetometer.kicad_sch, PTMS_INS.kicad_pcb, PTMS_INS.kicad_sch, mcu.kicad_sch]
2026-09-10 fix prev commit
    [mcu.kicad_sch]
2026-09-11 fixed electrical rules
    [Altimeter.kicad_sch, GPS.kicad_sch, IMU.kicad_sch, MCU_Power.kicad_sch, Magnetometer.kicad_sch, mcu.kicad_sch]
